lambdamikel/europc-keyboard/pics/adapter.jpg

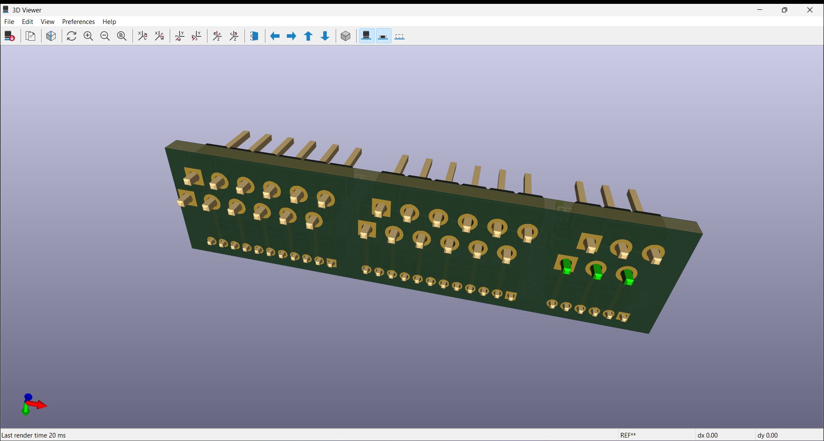
pics/adapter.jpg
