lambdamikel/europc-keyboard/(commit log)

2023-11-06 Gerbers and README uploaded.
2023-11-11 Adding KiCAD sources.
    [keyboard-B_Cu.gbr, keyboard-B_Mask.gbr, keyboard-Edge_Cuts.gbr, keyboard-F_Cu.gbr, keyboard-F_Mask.gbr, keyboard-F_Silkscreen.gbr, keyboard-NPTH.drl, keyboard-PTH.drl]
